shawnduong/badger-poc/README.md

# badger
Badger is an open source IoT RFID-based authentication, attendance tracking, notification, and rewards system for small to large scale events.
