shawnduong/badger-poc/schematics/badger.kicad_pcb

## KiCad design schematics/badger.kicad_pcb (2023-02-18)

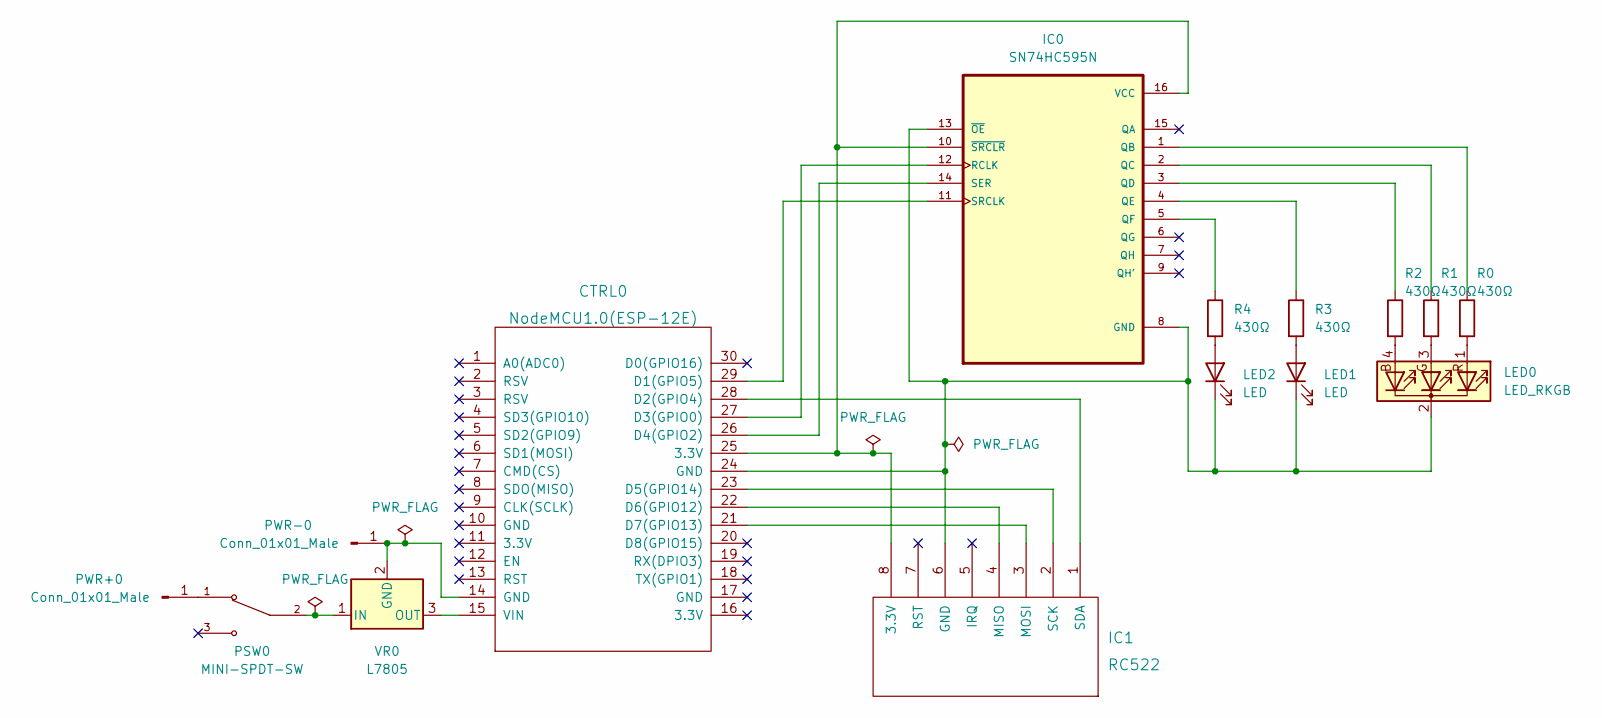
[picture p1: schematic badger.kicad_sch]

Parts:
CTRL0: NodeMCU1.0(ESP-12E); NodeMCU-LoLinV3
IC0: SN74HC595N; DIP794W45P254L1969H508Q16
IC1: RC522; rfid-rc522
LED0: LED_RKGB; LED_D5.0mm-4_RGB_Wide_Pins
LED1, LED2: LED; LED_D5.0mm
PSW0: MINI-SPDT-SW; SW_MINI-SPDT-SW; PARTREV C
PWR+0: Conn_01x01_Male; TestPoint_Pad_D2.0mm
PWR-0: Conn_01x01_Male; TestPoint_Pad_D2.0mm
R0, R1, R2, R3, R4: 430Ω; R_Axial_DIN0204_L3.6mm_D1.6mm_P7.62mm_Horizontal
VR0: L7805; TO-220-3_Vertical

Connections:
unnamed: CTRL0.14 (GND), PWR-0.1, VR0.2 (GND)
unnamed: CTRL0.15 (VIN), VR0.3 (OUT)
unnamed: CTRL0.21 (D7(GPIO13)), IC1.3 (MOSI)
unnamed: CTRL0.22 (D6(GPIO12)), IC1.4 (MISO)
unnamed: CTRL0.23 (D5(GPIO14)), IC1.2 (SCK)
unnamed: CTRL0.24 (GND), IC0.8 (GND), IC0.13 (~OE), IC1.6 (GND), LED0.2 (K), LED1.1 (K), LED2.1 (K)
unnamed: CTRL0.25 (3.3V), IC0.10 (~SRCLR), IC0.16 (VCC), IC1.8 (3.3V)
unnamed: CTRL0.26 (D4(GPIO2)), IC0.14 (SER)
unnamed: CTRL0.27 (D3(GPIO0)), IC0.12 (RCLK)
unnamed: CTRL0.28 (D2(GPIO4)), IC1.1 (SDA)
unnamed: CTRL0.29 (D1(GPIO5)), IC0.11 (SRCLK)
unnamed: IC0.1 (QB), R0.1
unnamed: IC0.2 (QC), R1.1
unnamed: IC0.3 (QD), R2.1
unnamed: IC0.4 (QE), R3.1
unnamed: IC0.5 (QF), R4.1
unnamed: LED0.1 (RA), R0.2
unnamed: LED0.3 (GA), R1.2
unnamed: LED0.4 (BA), R2.2
unnamed: LED1.2 (A), R3.2
unnamed: LED2.2 (A), R4.2
unnamed: PSW0.1, PWR+0.1
unnamed: PSW0.2, VR0.1 (IN)

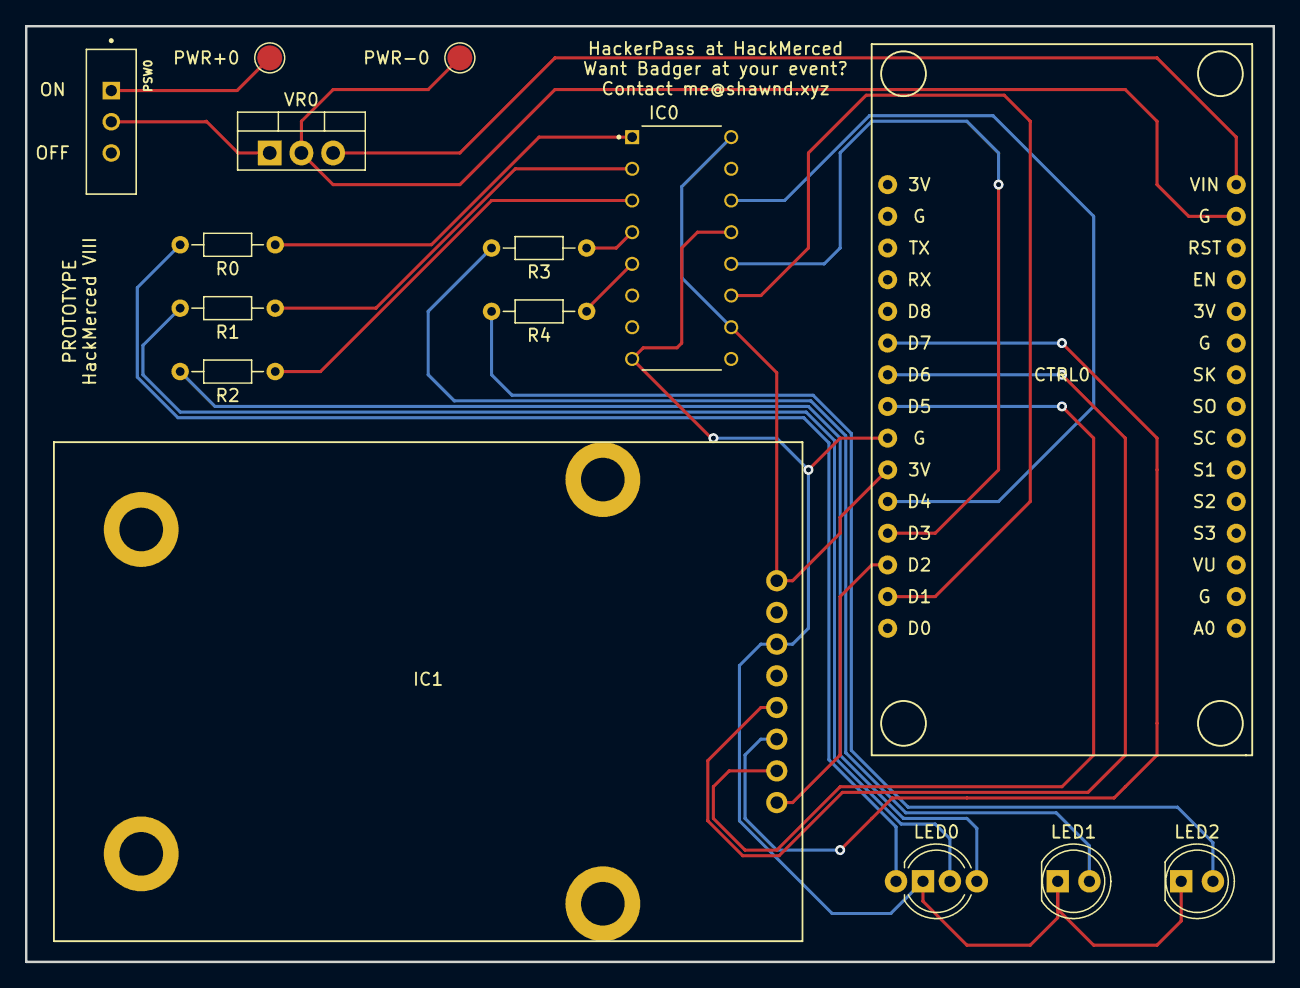
[picture p2: board badger.kicad_pcb from above]

Board: 2 copper layers, 100.0 x 75.0 mm, 15 parts (0 on the bottom side), 23 nets.
