shawnduong/badger-poc/src/firmware/badger/config.h

/* Unit unique 32-bit identifier. */
#define IDENTITY 0x00000000

/* Network details. */
#define NET_SSID "YOUR_SSID_HERE"
#define NET_PASS "YOUR_PASS_HERE"

/* How long to wait for a network. */
#define TIMEOUT 5000  // ms

/* Leave defined in we're in product testing mode. */
#define QA

/* API endpoint. Omit the trailing slash. */
#define API "https://YOUR_API_URL_HERE"
