shawnduong/badger-poc/(commit log)

2023-02-18 Added schematics.
    [badger-B_Cu.gbr, badger-B_Mask.gbr, badger-B_Paste.gbr, badger-B_Silkscreen.gbr, badger-Edge_Cuts.gbr, badger-F_Cu.gbr, badger-F_Mask.gbr, badger-F_Paste.gbr]
2023-02-19 Corrected colors in led header.
    [led.h]
2023-02-19 Changed network test response LED to status LED.
2023-02-19 Changed network connection LED to status LED for clarity.
2023-02-19 Printed MAC address to serial for whitelisting.
2023-02-20 Implemented Badger device healthcheck.
2023-02-21 Fixed negative UID bug.
    [api.h, badger.ino]
2023-02-21 Fixed sleep mode for power savings.
    [badger.ino, networking.h]
